anshulsanam/The-UnbreakaBLE-Micro-Drone/README.md

# The-UnbreakaBLE-Micro-Drone

This repo contains all the hardware for the drone including schematics, board files, and even 3d print files.
