anshulsanam/The-UnbreakaBLE-Micro-Drone/HexcopterBOM.xlsx

Qty | Value | Package | Parts | Link | Qty ordered | Unit Price
1 | PCBs |  |  | oshpark
1 |  | LTC3200 | LTC3200 | link (http://www.linear.com/product/LTC3200) | 2 | 0
1 | 0.01uF | 402 | C11 | link (http://www.mouser.com/ProductDetail/Murata-Electronics/GRM155R71H103JA88D/) | 3 | 0.1
1 |  | SWITCH_SPST_SMD_A | S2 | link (http://www.mouser.com/ProductDetail/ALPS/SSSS810701/) | 3 | 0.2
5 | 0.1UF | 402 | C6, C7, C12, C13, C17 | link (http://www.mouser.com/Search/ProductDetail.aspx) | 15 | 0.03
1 | 0.22UF | 0603 | C14 | link (http://www.mouser.com/Search/ProductDetail.aspx?qs=o%252b57EFQVsgK1lNFrWcCThg%3d%3d) | 3 | 0.1
1 | 1.0UF | 0402 | C1 | link (http://www.mouser.com/ProductDetail/Murata-Electronics/GRM155R60J105KE19D/) | 3 | 0.1
1 | 2.0K | 0603 | R19 | link (http://www.mouser.com/ProductDetail/Vishay/CRCW06032K00FKEA/) | 3 | 0.1
3 | 2.2UF | 0603 | C4, C9, C10 | link (http://www.mouser.com/ProductDetail/AVX/0603ZD225KAT4A/) | 9 | 0.1
1 | 3.3V/150MA | SOT23-5 | U5 | link (http://www.mouser.com/ProductDetail/Microchip-Technology-Micrel/MIC5205-33YM5-TR/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) | 3 | 0.48
2 | 4.7K | 0603 | R21, R22 | link (http://www.mouser.com/ProductDetail/Vishay/CRCW06034K70FKEA/?qs=sGAEpiMZZMtlubZbdhIBIGYvcJJnxxxrQwDimOdk6Uk%3d) | 6 | 0.1
1 | 4.7UF | 0603 | C15 | link (http://www.mouser.com/Search/ProductDetail.aspx) | 3 | 0.13
8 | 10K | 0603 | R2, R5, R7, R8, R10, R13, R15, R24 | link (http://www.mouser.com/ProductDetail/Vishay-Draloric/CRCW060310K0JNEAHP/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) | 24 | 0.109
2 | 10UF | 0603 | C3, C5 | link (http://www.mouser.com/ProductDetail/Murata-Electronics/GRM188R60J106ME47J/) | 6 | 0.15
1 | 16MHZ | RESONATOR-SMD | Y2 | link (http://www.mouser.com/Search/ProductDetail.aspx) | 3 | 0.46
2 | 22 | 0402 | R12, R14 | link (http://www.mouser.com/ProductDetail/Panasonic/ERJ-2RKF22R0X/?qs=sGAEpiMZZMu61qfTUdNhGyaNAXkG0mENFLV8qYewzuk%3d) | 6 | 0.1
1 | 32U4 | QFN-44-NOPAD | U$1 |  | 3 | 0
8 | 330ohm | 0603 | R1, R3, R4, R6, R9, R11, R17, R18 | link (http://www.mouser.com/ProductDetail/Bourns/CR0603-FX-3300ELF/) | 24 | 0.025
3 | 68ohm | 603 | R16, R20, R23 | link (http://www.mouser.com/ProductDetail/ROHM-Semiconductor/ESR03EZPJ680/) | 9 | 0.1
3 | BLUE | CHIPLED_1206 | LED1, LED2, LED3 | link (https://www.sparkfun.com/products/12620) | 9 | 0
1 | GREEN | LED-0603 | D1 | link (http://www.mouser.com/ProductDetail/Wurth-Electronics/150060VS75000/) | 3 | 0.14
1 | HM-11 | HM-11 | U$6 | link (https://www.amazon.com/Qunqi-HM-11-Bluetooth-Anti-lost-Android/dp/B015C6DIBO?s=electronics) | 1 | 11.99
6 | IRLML2502 | SOT23 | Q1, Q2, Q3, Q4, Q5, Q6 | link (http://www.mouser.com/Search/ProductDetail.aspx?qs=9%252bKlkBgLFf00OMWIkGxDCg%3d%3d) | 12 | 0.319
1 | MCP73831/OT | SOT23-5L | IC2 | link (http://www.mouser.com/ProductDetail/Microchip/MCP73831T-2ACI-OT/) | 3 | 0.6
1 | MPU-9250 | QFN-24-EP | U3 | link (https://www.amazon.com/gp/product/B01ID63R1G/ref=ox_sc_act_title_1?smid=A1OB26G8TSLEZQ&psc=1) | 1 | 8.66
1 | MS5611-01BA01 | MS5611-01BA01 | U$9 | link (https://www.arrow.com/en/products/ms561101ba03-00/te-connectivity) | 1 | 13.242
1 | RED | LED-0603 | D4 | link (http://www.mouser.com/ProductDetail/Wurth-Electronics/150060SS75000/) | 3 | 0.14
1 | USB-MICROB | USB-MICROB | J1 | link (http://www.mouser.com/ProductDetail/Wurth-Electronics/629105136821/) | 3 | 1.21
 | battery |  |  | link (https://hobbyking.com/en_us/turnigy-nano-tech-750mah-1s-35-70c-lipo-pack-fits-nine-eagles-solo-pro-180.html)
 |  |  |  |  | total = | 56.566
