anshulsanam/The-UnbreakaBLE-Micro-Drone/Body.stl

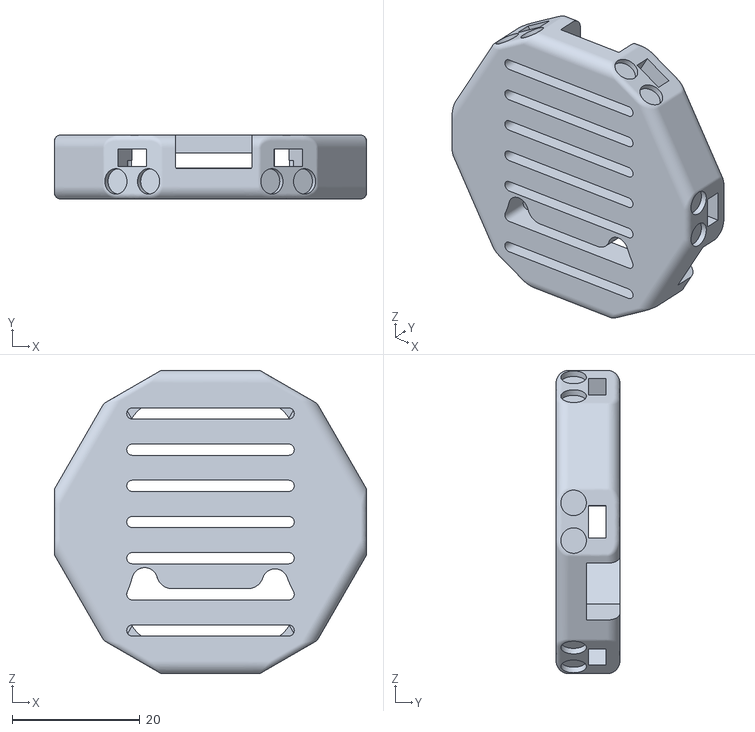
[picture p1: CAD file, 2017-07-24]
Body.stl
48.9 x 10.0 x 47.5
