anshulsanam/The-UnbreakaBLE-Micro-Drone/BodyLid.stl

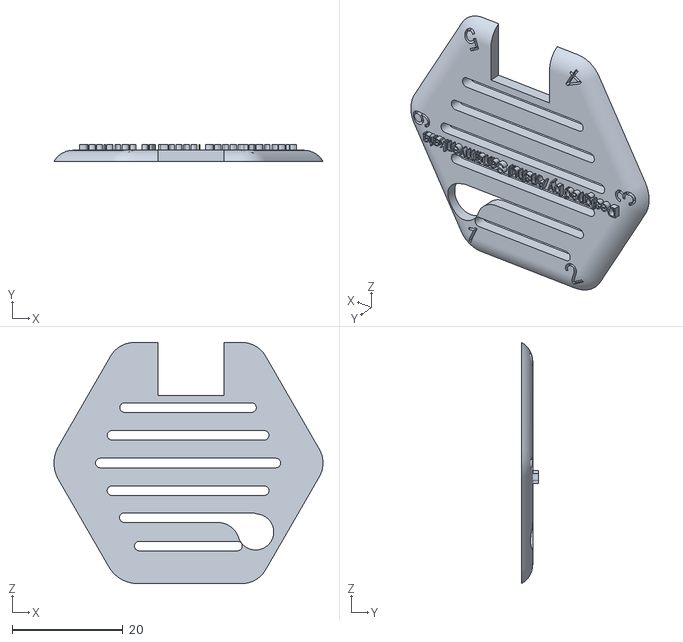
[picture p2: CAD file, 2017-07-24]
BodyLid.stl
48.6 x 3.00 x 43.5
