anshulsanam/The-UnbreakaBLE-Micro-Drone/BoardSchematics.pdf

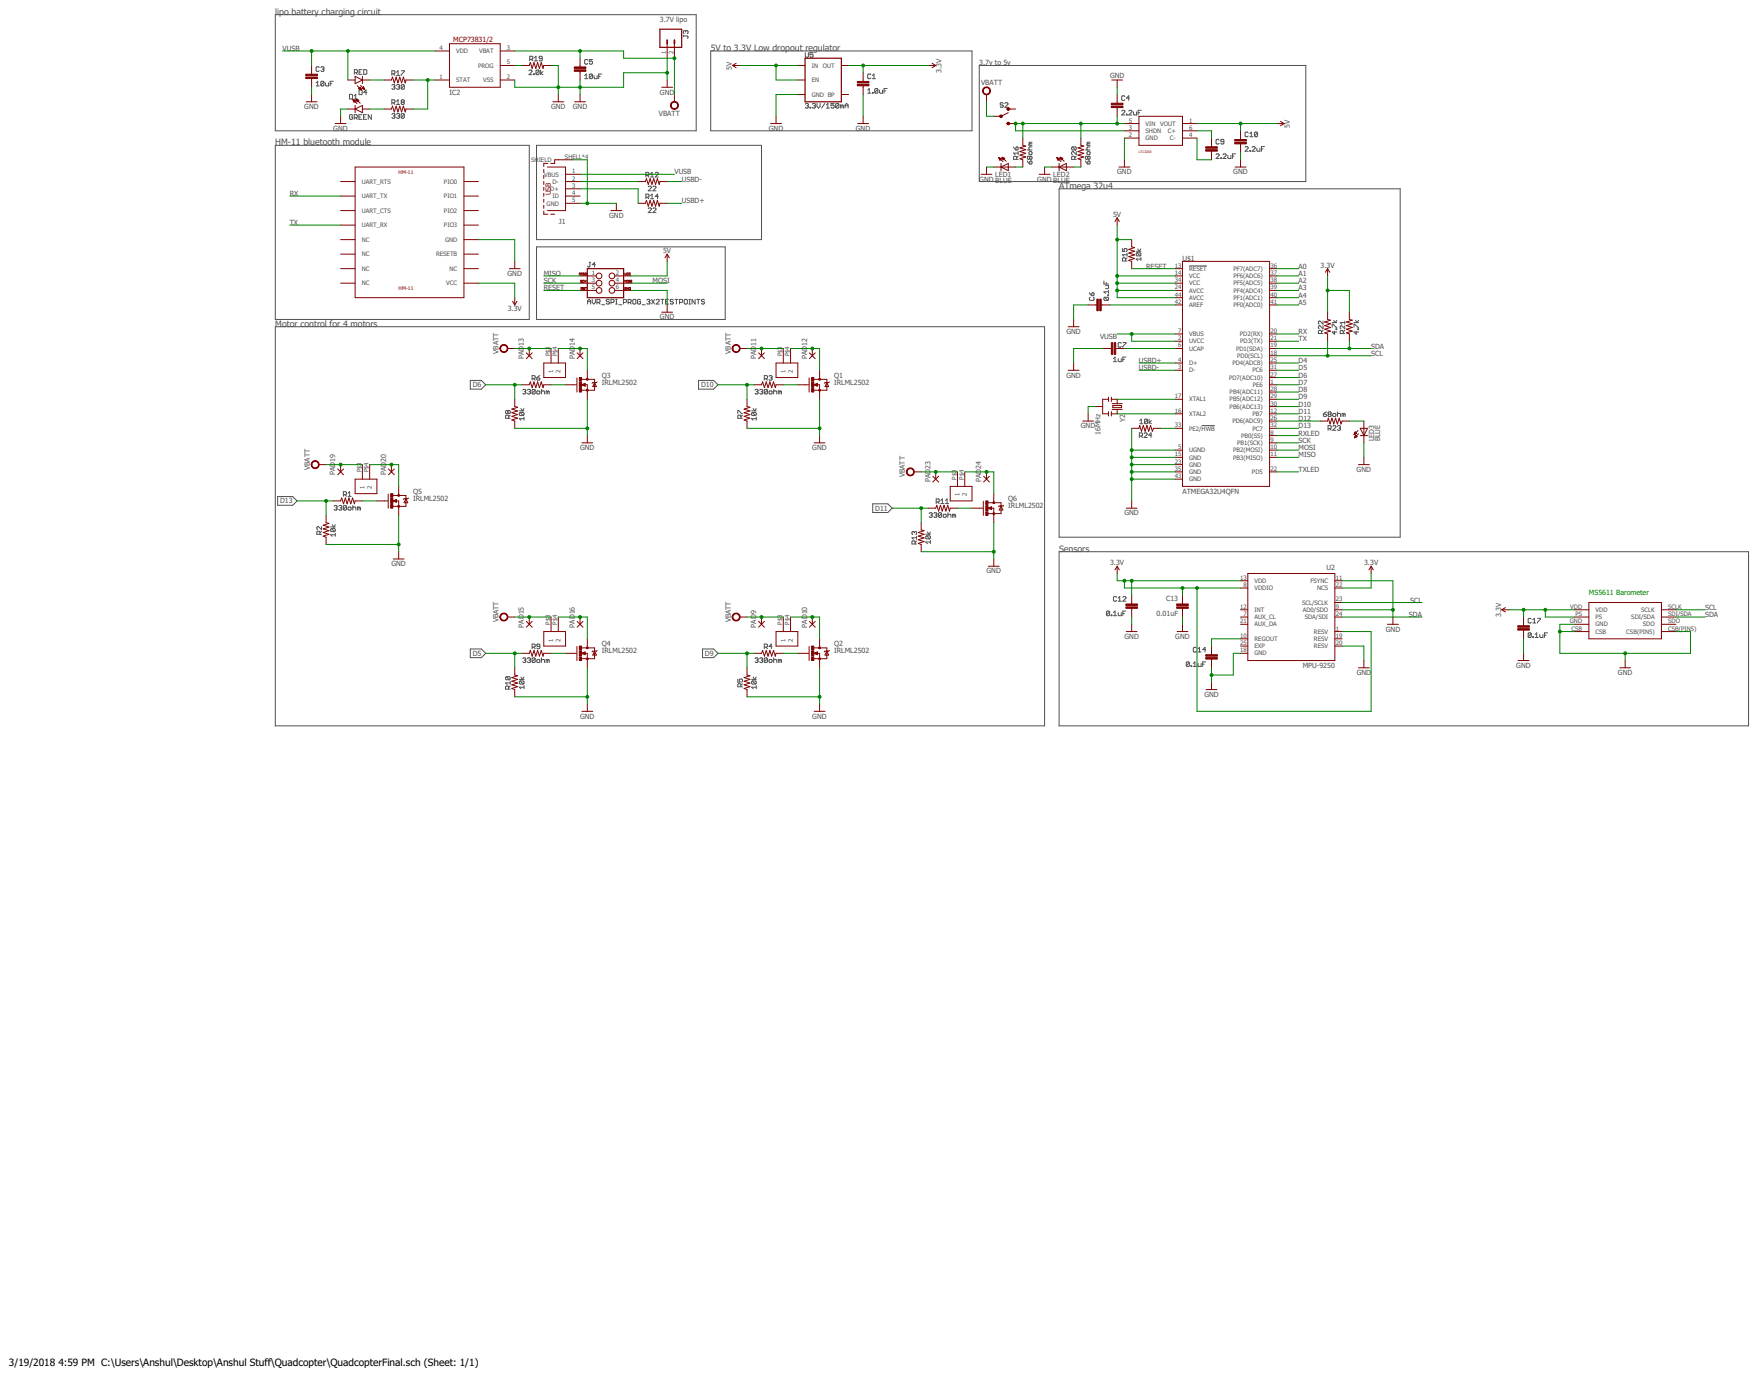
[picture p3: page 1]

lipo battery charging circuit

5V to 3.3V Low dropout regulator

Motor control for 4 motors

3/19/2018 4:59 PM C:\Users\Anshul\Desktop\Anshul Stuff\Quadcopter\QuadcopterFinal.sch (Sheet: 1/1)
