anshulsanam/The-UnbreakaBLE-Micro-Drone/QuadcopterFinal.brd

## EAGLE design QuadcopterFinal.brd (2018-03-19)

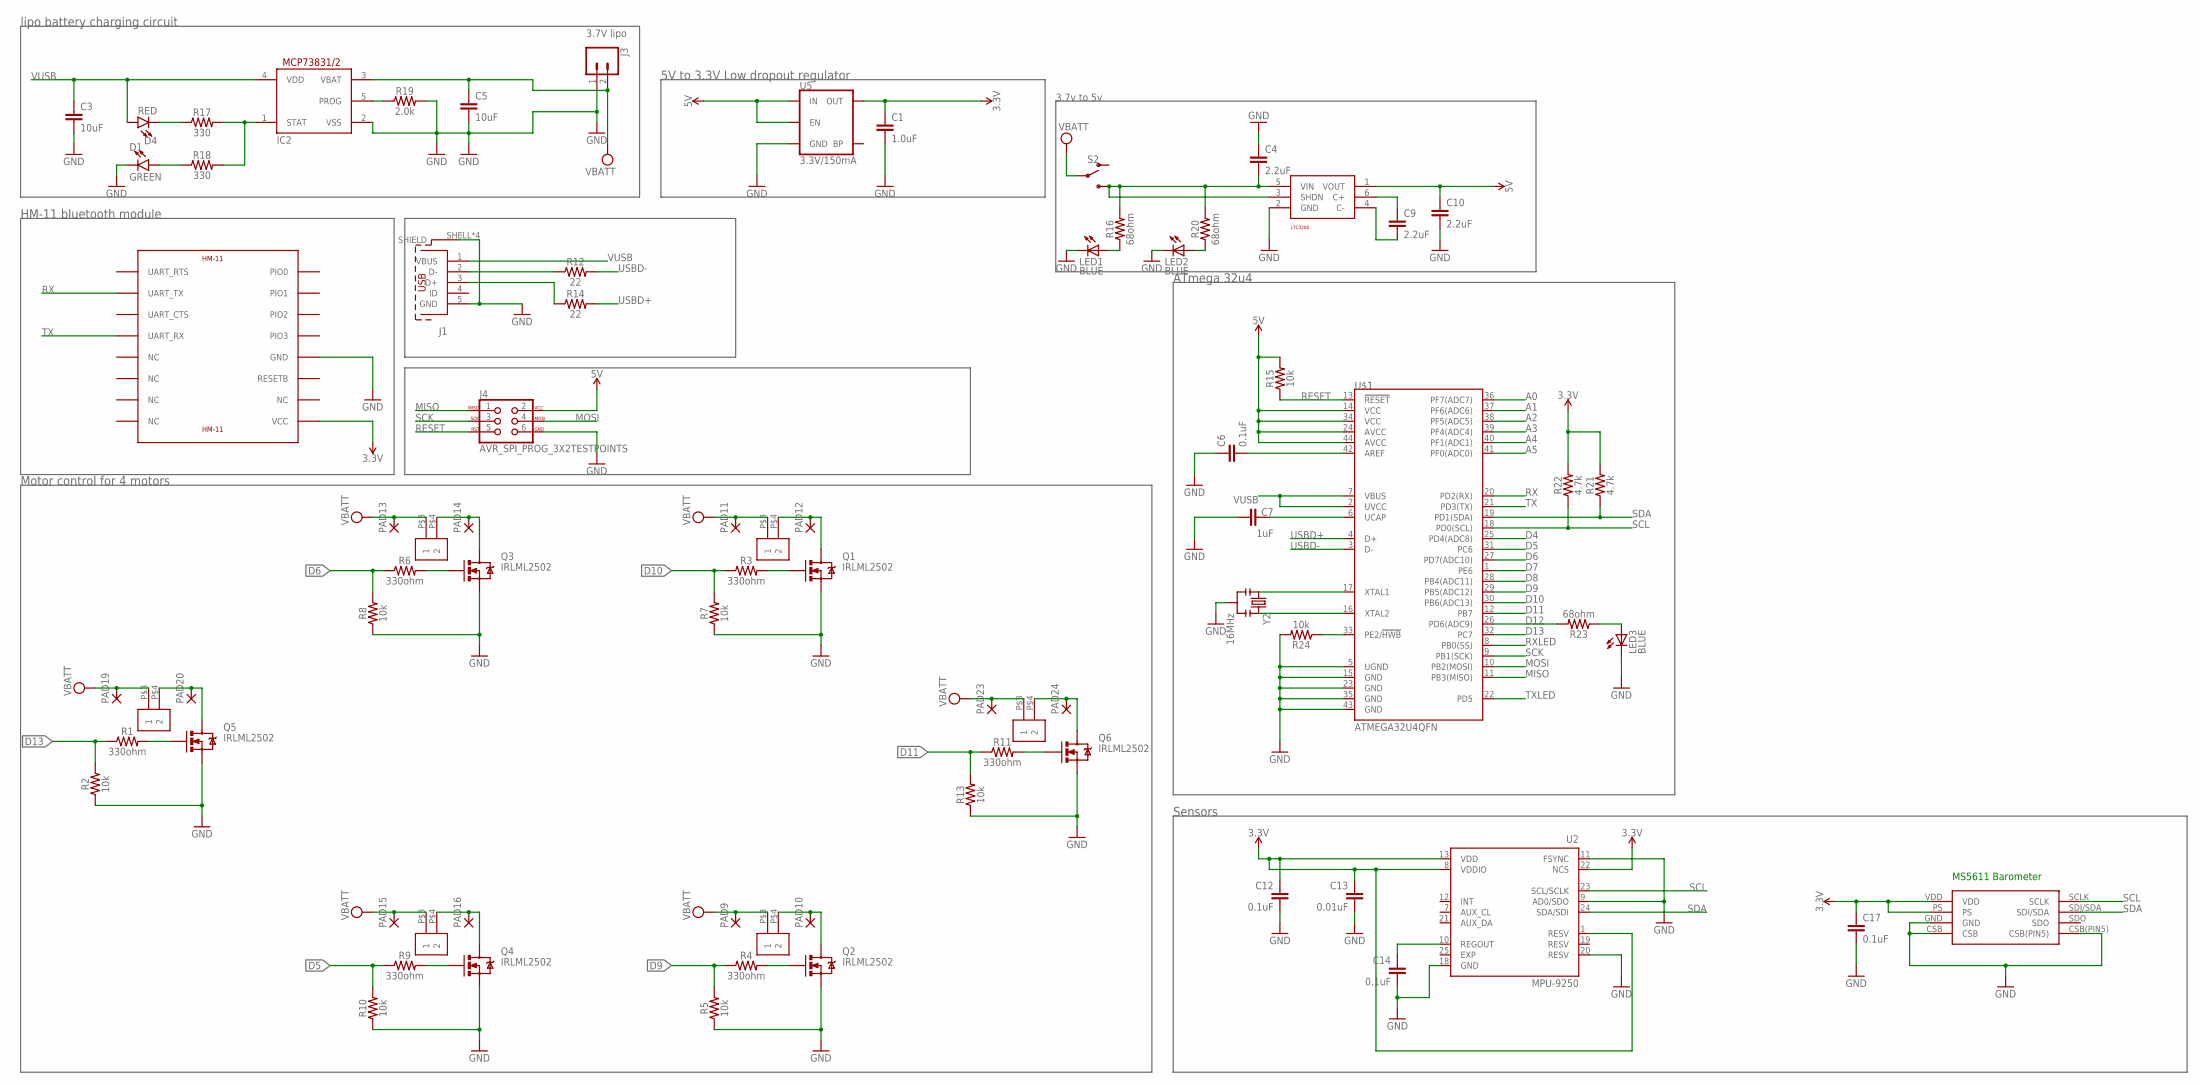
[picture p4: schematic QuadcopterFinal.sch]

Parts:
C1: 1.0uF; 0402
C3, C5: 10uF; 0603
C4, C9, C10: 2.2uF; 0603
C6, C12, C14, C17: 0.1uF; 0402
C7: 1uF; 0402
C13: 0.01uF; C0402
D1: GREEN; LED-0603
D4: RED; LED-0603
IC2: MCP73831/OT; SOT23-5L
J1: 629105136821
J3: CONN_021X02_NO_SILK; 1X02_NO_SILK
J4: AVR_SPI_PROG_3X2TESTPOINTS; 2X3_TEST_POINTS
LED1, LED2, LED3: BLUE; CHIPLED_1206
LTC3200: LTC3200
PAD9, PAD10, PAD11, PAD12, PAD13, PAD14, PAD15, PAD16, PAD19, PAD20, PAD23, PAD24: SMD2; SMD1,27-2,54
Q1, Q2, Q3, Q4, Q5, Q6: IRLML2502; SOT23
R1, R3, R4, R6, R9, R11: 330ohm; 0603
R2, R5, R7, R8, R10, R13, R15, R24: 10k; 0603
R12, R14: 22; 0402
R16, R20, R23: 68ohm; 0603
R17, R18: 330; 0603
R19: 2.0k; 0603
R21, R22: 4.7k; 0603
S2: SWITCH-SPDT-SMD-RIGHT-ANGLE; SWITCH_SPST_SMD_A
U2: MPU-9250; QFN40P300X300X105-25N
U5: 3.3V/150mA; SOT23-5
U$1: ATMEGA32U4QFN; SPARKFUN-DIGITALIC_QFN-44
U$2, U$3, U$4, U$5, U$7, U$8: QUADARM
U$6: HM-11
U$9: MS5611-01BA01
Y2: 16MHz; RESONATOR-SMD

Connections:
3.3V: C1.1, C12.1, C13.1, C17.1, R21.2, R22.2, U2.1 (RESV), U2.8 (VDDIO), U2.13 (VDD), U2.22 (NCS), U5.5 (OUT), U$6.VCC, U$9.PS, U$9.VDD
5V: C10.1, J4.2, LTC3200.1 (VOUT), R15.2, U5.1 (IN), U5.3 (EN), U$1.14 (VCC), U$1.24 (AVCC), U$1.34 (VCC), U$1.44 (AVCC)
A0: U$1.36 (PF7(ADC7))
A1: U$1.37 (PF6(ADC6))
A2: U$1.38 (PF5(ADC5))
A3: U$1.39 (PF4(ADC4))
A4: U$1.40 (PF1(ADC1))
A5: U$1.41 (PF0(ADC0))
D4: U$1.25 (PD4(ADC8))
D5: R9.1, R10.2, U$1.31 (PC6)
D6: R6.1, R8.2, U$1.27 (PD7(ADC10))
D7: U$1.1 (PE6)
D8: U$1.28 (PB4(ADC11))
D9: R4.1, R5.2, U$1.29 (PB5(ADC12))
D10: R3.1, R7.2, U$1.30 (PB6(ADC13))
D11: R11.1, R13.2, U$1.12 (PB7)
D12: R23.2, U$1.26 (PD6(ADC9))
D13: R1.1, R2.2, U$1.32 (PC7)
EXP: U2.25 (EXP)
GND: C1.2, C3.2, C4.1, C5.2, C6.1, C7.1, C10.2, C12.2, C13.2, C14.2, C17.2, D1.C, IC2.2 (VSS), J1.5 (GND), J1.SHELL (SHIELD), J1.SHELL1 (SHIELD), J1.SHELL2 (SHIELD), J1.SHELL3 (SHIELD), J3.1, J4.6, LED1.C, LED2.C, LED3.C, LTC3200.2 (GND), Q1.2 (S), Q2.2 (S), Q3.2 (S), Q4.2 (S), Q5.2 (S), Q6.2 (S), R2.1, R5.1, R7.1, R8.1, R10.1, R13.1, R19.2, R24.2, U2.9 (AD0/SDO), U2.11 (FSYNC), U2.18 (GND), U2.20 (RESV), U5.2 (GND), U$1.5 (UGND), U$1.15 (GND), U$1.23 (GND), U$1.35 (GND), U$1.43 (GND), U$6.GND, U$9.CSB, U$9.CSB(PIN5), U$9.GND, Y2.2
MISO: J4.1, U$1.11 (PB3(MISO))
MOSI: J4.4, U$1.10 (PB2(MOSI))
unnamed: Q5.1 (G), R1.2
unnamed: C4.2, LTC3200.3 (SHDN), LTC3200.5 (VIN), R16.2, R20.2, S2.3 (S)
unnamed: PAD20.1, Q5.3 (D), U$7.P$4 (2)
unnamed: Q6.1 (G), R11.2
unnamed: LED1.A, R16.1
unnamed: PAD24.1, Q6.3 (D), U$8.P$4 (2)
unnamed: Q1.1 (G), R3.2
unnamed: PAD12.1, Q1.3 (D), U$3.P$4 (2)
unnamed: LED2.A, R20.1
unnamed: Q2.1 (G), R4.2
unnamed: PAD10.1, Q2.3 (D), U$2.P$4 (2)
unnamed: J1.2 (D-), R12.1
unnamed: Q3.1 (G), R6.2
unnamed: PAD14.1, Q3.3 (D), U$4.P$4 (2)
unnamed: J1.3 (D+), R14.1
unnamed: Q4.1 (G), R9.2
unnamed: PAD16.1, Q4.3 (D), U$5.P$4 (2)
unnamed: U$1.17 (XTAL1), Y2.1
unnamed: C9.1, LTC3200.6 (C+)
unnamed: C14.1, U2.10 (REGOUT)
unnamed: C9.2, LTC3200.4 (C-)
unnamed: D4.C, R17.1
unnamed: IC2.1 (STAT), R17.2, R18.2
unnamed: D1.A, R18.1
unnamed: U$1.16 (XTAL2), Y2.3
unnamed: LED3.A, R23.1
unnamed: IC2.5 (PROG), R19.1
unnamed: R24.1, U$1.33 (PE2/!HWB)
unnamed: C6.2, U$1.42 (AREF)
unnamed: C7.2, U$1.6 (UCAP)
RESET: J4.5, R15.1, U$1.13 (!RESET)
RESV: U2.19 (RESV)
RX: U$1.20 (PD2(RX)), U$6.UART_TX
RXLED: U$1.8 (PB0(SS))
SCK: J4.3, U$1.9 (PB1(SCK))
SCL: R22.1, U2.23 (SCL/SCLK), U$1.18 (PD0(SCL)), U$9.SCLK
SDA: R21.1, U2.24 (SDA/SDI), U$1.19 (PD1(SDA)), U$9.SDI/SDA
TX: U$1.21 (PD3(TX)), U$6.UART_RX
TXLED: U$1.22 (PD5)
USBD+: R14.2, U$1.4 (D+)
USBD-: R12.2, U$1.3 (D-)
VDD: C5.1, IC2.3 (VBAT), J3.2, PAD9.1, PAD11.1, PAD13.1, PAD15.1, PAD19.1, PAD23.1, S2.2, U$2.P$3 (1), U$3.P$3 (1), U$4.P$3 (1), U$5.P$3 (1), U$7.P$3 (1), U$8.P$3 (1)
VUSB: C3.1, D4.A, IC2.4 (VDD), J1.1 (VBUS), U$1.2 (UVCC), U$1.7 (VBUS)

Notes on the sheet:
3.7V lipo
Sensors
5V to 3.3V Low dropout regulator
HM-11 bluetooth module
Motor control for 4 motors
ATmega 32u4
3.7v to 5v
MS5611 Barometer
lipo battery charging circuit

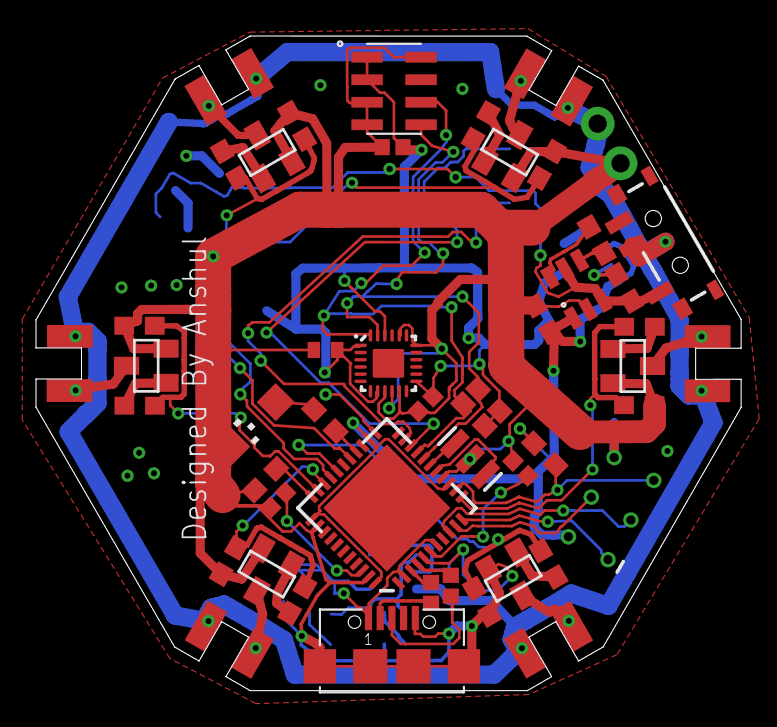
[picture p5: board QuadcopterFinal.brd from above]

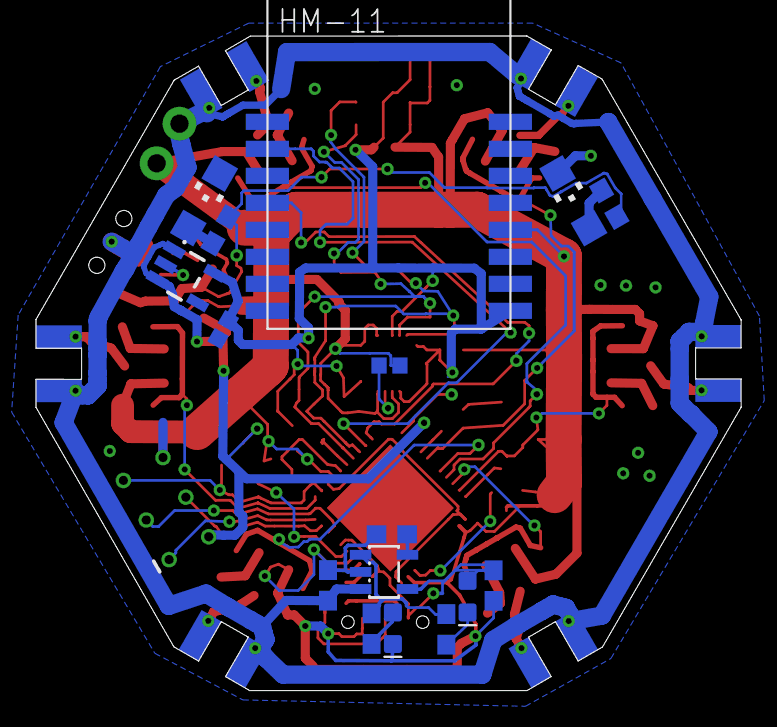
[picture p6: board QuadcopterFinal.brd from below]

Board: 2 copper layers, 39.2 x 36.4 mm, 77 parts (28 on the bottom side), 52 nets.
